jakhon37/autoJetsonBot/tmp_rovodev_long_term_plan.md

# Long-Term Development Plan: ROS2 Control Integration with diffdrive_arduino

## Current State Analysis

### Existing Issues Identified:
1. **Fragmented Control Architecture**: Multiple control paradigms (micro_ros, diffdrive_arduino, legacy GPIO)
2. **Hardcoded Launch Parameters**: No dynamic switching between sim/real
3. **Configuration Inconsistencies**: Different encoder counts, topic names, frame IDs
4. **Missing Hardware Abstraction**: Direct hardware dependencies in launch files
5. **Incomplete Integration**: diffdrive_arduino configured but not properly integrated

## Long-Term Development Plan (6-Month Roadmap)

### Phase 1: Foundation & Cleanup (Month 1-2)
#### 1.1 Unified Configuration System
- Create centralized parameter management
- Standardize encoder resolution across all systems
- Implement environment-specific configuration loading

#### 1.2 Hardware Interface Standardization
- Complete diffdrive_arduino integration
- Remove conflicting micro_ros dependencies
- Standardize communication protocols

#### 1.3 Launch System Refactoring
- Create unified launch architecture
- Implement proper parameter passing
- Add validation and error handling

### Phase 2: Core Integration (Month 2-3)
#### 2.1 ROS2 Control Framework Integration
- Complete diffdrive_arduino hardware interface
- Implement proper controller spawning
- Add real-time performance monitoring

#### 2.2 Simulation-Real Hardware Parity
- Ensure identical behavior between sim and real
- Standardize topic names and frame IDs
- Implement seamless switching mechanism

#### 2.3 Safety & Monitoring Systems
- Add hardware health monitoring
- Implement emergency stop mechanisms
- Create diagnostic and logging systems

### Phase 3: Advanced Features (Month 3-4)
#### 3.1 Hardware Abstraction Layer
- Create modular hardware interfaces
- Implement plugin-based architecture
- Add support for different motor controllers

#### 3.2 Automated Deployment
- Create deployment scripts
- Implement configuration validation
- Add automated testing framework

#### 3.3 Performance Optimization
- Optimize control loop timing
- Implement adaptive control parameters
- Add performance profiling tools

### Phase 4: Production Readiness (Month 4-5)
#### 4.1 Robust Error Handling
- Implement comprehensive error recovery
- Add graceful degradation modes
- Create system health monitoring

#### 4.2 Documentation & Testing
- Complete system documentation
- Implement comprehensive test suite
- Create user guides and tutorials

#### 4.3 Maintenance & Updates
- Create update mechanisms
- Implement version control for configurations
- Add remote monitoring capabilities

### Phase 5: Advanced Features & Optimization (Month 5-6)
#### 5.1 AI/ML Integration
- Implement adaptive control algorithms
- Add predictive maintenance features
- Create learning-based optimization

#### 5.2 Cloud Integration
- Add remote monitoring and control
- Implement data logging and analytics
- Create fleet management capabilities

#### 5.3 Scalability & Modularity
- Design for multiple robot support
- Implement modular sensor integration
- Create extensible architecture

## Implementation Details

### Immediate Actions (Week 1-2)
1. **Audit Current diffdrive_arduino Integration**
2. **Create Unified Parameter Schema**
3. **Design Hardware Abstraction Interface**
4. **Plan Migration Strategy**

### Critical Dependencies
- diffdrive_arduino package compatibility
- ROS2 Control framework version alignment
- Hardware driver stability
- Testing infrastructure setup

### Success Metrics
- Single command deployment (sim/real)
- Zero configuration conflicts
- <100ms control loop latency
- 99.9% system uptime
- Automated testing coverage >90%

### Risk Mitigation
- Maintain backward compatibility during transition
- Implement gradual migration strategy
- Create rollback mechanisms
- Establish comprehensive testing protocols

## Resource Requirements
- Development time: 6 months (1 FTE)
- Hardware testing setup
- Continuous integration infrastructure
- Documentation and training materials

## Expected Outcomes
- Production-ready autonomous robot platform
- Seamless sim-to-real deployment
- Maintainable and extensible codebase
- Comprehensive monitoring and diagnostics
- Industry-standard development practices
