jakhon37/autoJetsonBot/src/robot_body/urdf/robot_dimension.txt

    """ my robot dimensions:

        base: 
            - center point between the wheels: 0 0 0

        chassis:
            - length: 145 mm
            - width: 140 mm
            - height: 70  mm

            - chassis origin point: -30 0 0 mm (behind the center point between the wheels)

    """
