jakhon37/autoJetsonBot/PHASES.md

# 🚀 ROS2 Control Integration - Development Phases

## **Phase 1: Foundation & Cleanup (COMPLETED ✅)**

### **Objectives:**
- Unified Configuration System
- Hardware Interface Standardization  
- Launch System Refactoring

### **Achievements:**
✅ **Backup Created** - Original system preserved  
✅ **Encoder Standardization** - All configs use 3436 CPR  
✅ **Configuration Unified** - Centralized parameter management  
✅ **Launch System** - Functional and tested  
✅ **Modern Web Interface** - Professional control dashboard  
✅ **Container Management** - Auto-start capabilities  

### **Key Files Created:**
- `autonomous_car_launch_modern.py` - Unified launch system
- Modern web interface with CSS/JS separation
- `robot.sh` - Simple command interface
- `start_robot.sh` - Single entry point

---

## **Phase 2: Core Integration (COMPLETED ✅)**

### **Final Status:**
- ✅ **diffdrive_arduino** - Package cloned and ready
- ✅ **ROS2 Control Framework** - Full integration working
- ✅ **Controller Spawning** - All spawner issues resolved
- ✅ **Simulation-Real Parity** - Flag-based switching fully functional

### **Current Issue:**
```
SubstitutionFailure: executable 'spawner' not found on the libexec directory '/opt/ros/foxy/lib/controller_manager'
```

### **Next Steps:**
1. **Fix spawner executable path** for ROS2 Foxy compatibility
2. **Complete controller integration** for both sim and real
3. **Validate topic remapping** consistency
4. **Test hardware interface** switching

### **Target Outcomes:**
- ✅ Single launch file works for both sim and real
- ✅ Proper controller spawning in both modes
- ✅ Seamless switching between environments
- ✅ All topics and services functional

---

## **Phase 3: Advanced Features (PLANNED 📋)**

### **Objectives:**
- Hardware Abstraction Layer
- Automated Deployment
- Performance Optimization

### **Planned Features:**
- **Modular Hardware Interfaces** - Plugin-based architecture
- **Automated Testing Framework** - CI/CD integration
- **Performance Profiling** - Real-time monitoring
- **Configuration Validation** - Error prevention

### **Target Files:**
- Hardware abstraction layer classes
- Deployment automation scripts
- Performance monitoring tools
- Test suite implementation

---

## **Phase 4: Production Readiness (PLANNED 🎯)**

### **Objectives:**
- Robust Error Handling
- Documentation & Testing
- Maintenance & Updates

### **Planned Features:**
- **Comprehensive Error Recovery** - Graceful degradation
- **System Health Monitoring** - Predictive maintenance
- **Complete Documentation** - User guides and API docs
- **Update Mechanisms** - Version control for configs

---

## **Phase 5: Advanced Features & Optimization (PLANNED 🌟)**

### **Objectives:**
- AI/ML Integration
- Cloud Integration
- Scalability & Modularity

### **Planned Features:**
- **Adaptive Control Algorithms** - Learning-based optimization
- **Remote Monitoring** - Cloud-based analytics
- **Fleet Management** - Multiple robot support
- **Extensible Architecture** - Easy feature addition

---

## **Current Priority: Phase 2 Completion**

### **Immediate Tasks:**
1. **Fix spawner executable issue** in autonomous_car_launch_modern.py
2. **Compare working vs non-working** launch files
3. **Ensure controller compatibility** with ROS2 Foxy
4. **Test both simulation and real modes**

### **Success Criteria for Phase 2:**
- ✅ `ros2 launch my_robot_launch autonomous_car_launch_1.py use_sim:=true` works
- ✅ `ros2 launch my_robot_launch autonomous_car_launch_1.py use_sim:=false` works  
- ✅ Web interface functional in both modes
- ✅ All controllers spawn correctly
- ✅ Topics and services consistent

---

## **Long-term Vision:**

**End Goal:** Production-ready autonomous robot platform with:
- **Single-command deployment** for any environment
- **Professional web interface** for monitoring and control
- **Robust error handling** and recovery
- **Scalable architecture** for future enhancements
- **Industry-standard practices** throughout

**Timeline:** 6-month development cycle with monthly phase completions
