jakhon37/autoJetsonBot/assets/circuit_image.png

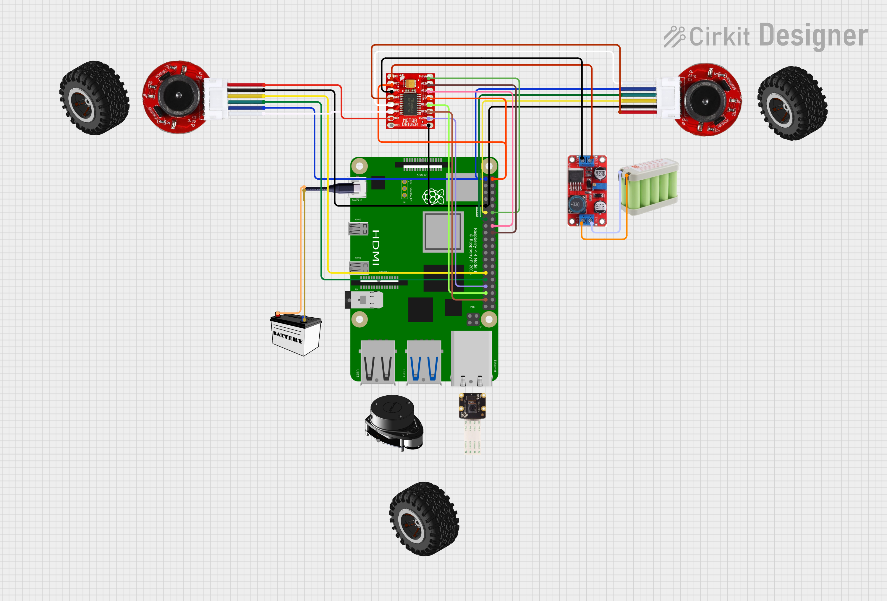
assets/circuit_image.png
