jakhon37/autoJetsonBot/assets/encoder.jpg

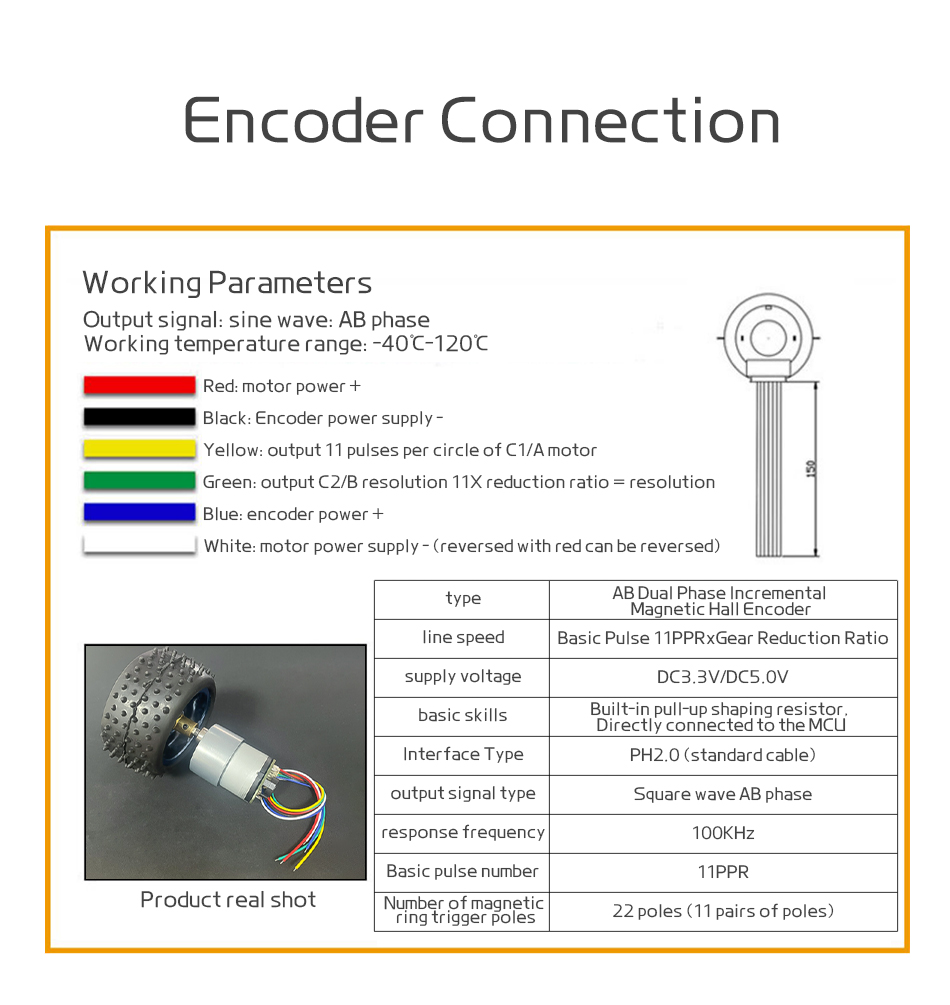
assets/encoder.jpg
