jakhon37/autoJetsonBot/assets/gitpage.png

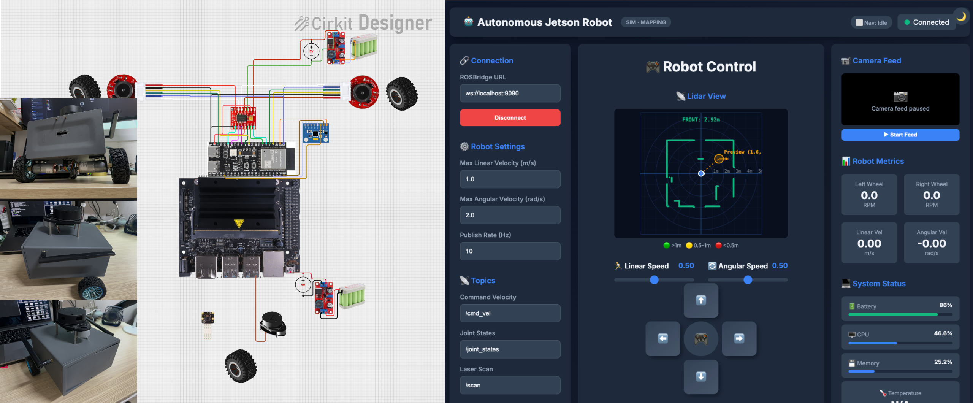
assets/gitpage.png
