jakhon37/autoJetsonBot/assets/jetson/16536_11.jpg

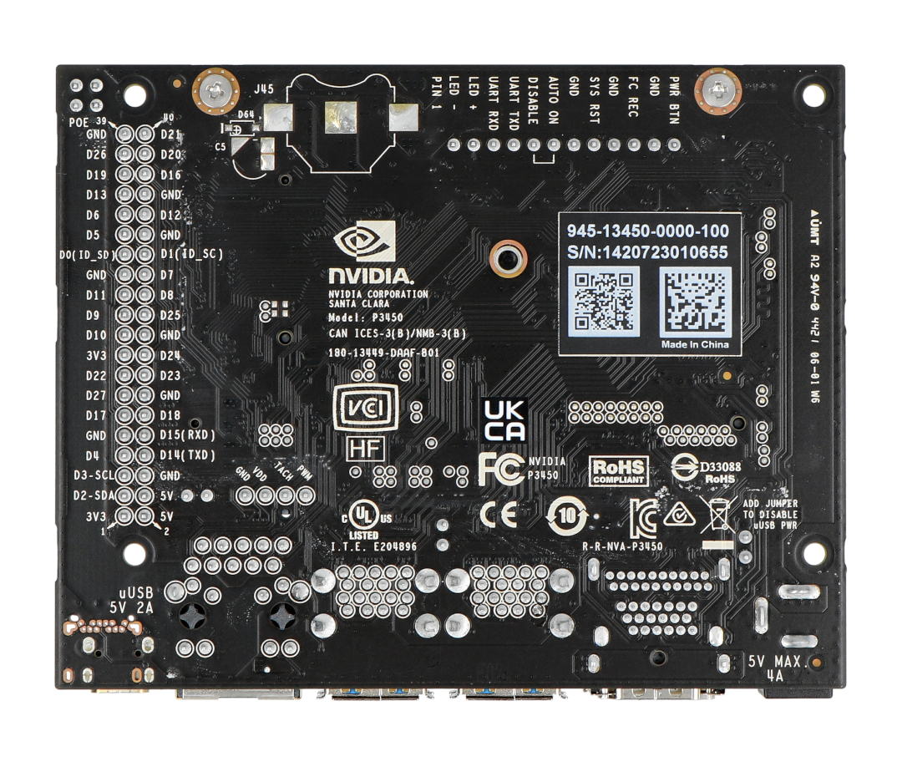
assets/jetson/16536_11.jpg
