jakhon37/autoJetsonBot/assets/jetson/image_2823.jpg

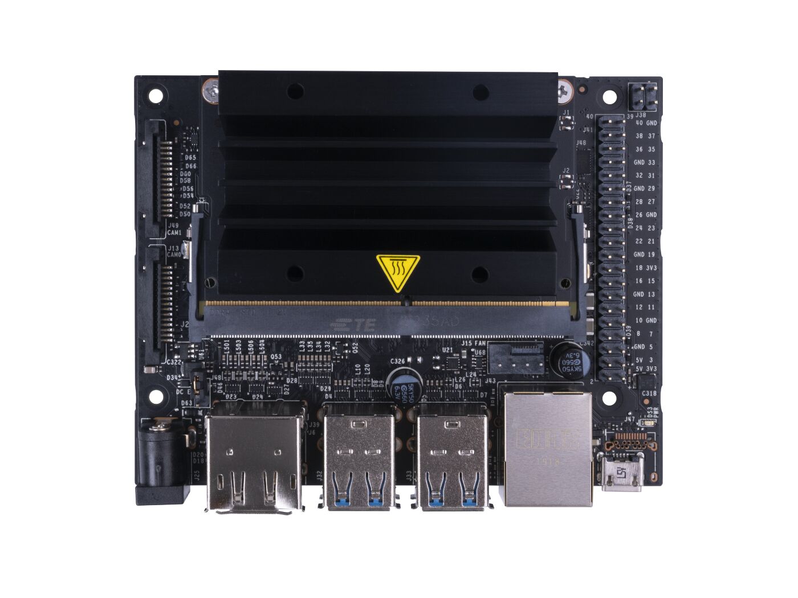
assets/jetson/image_2823.jpg
