jakhon37/autoJetsonBot/assets/jetson/nano_b1 board.png

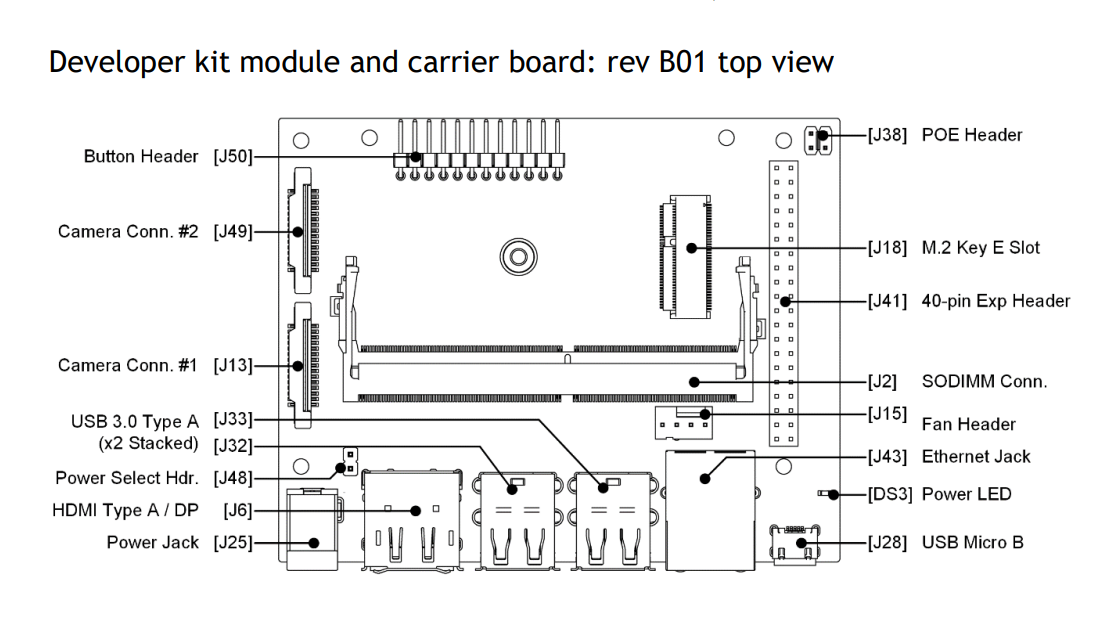
assets/jetson/nano_b1 board.png
