jakhon37/autoJetsonBot/assets/motor.png

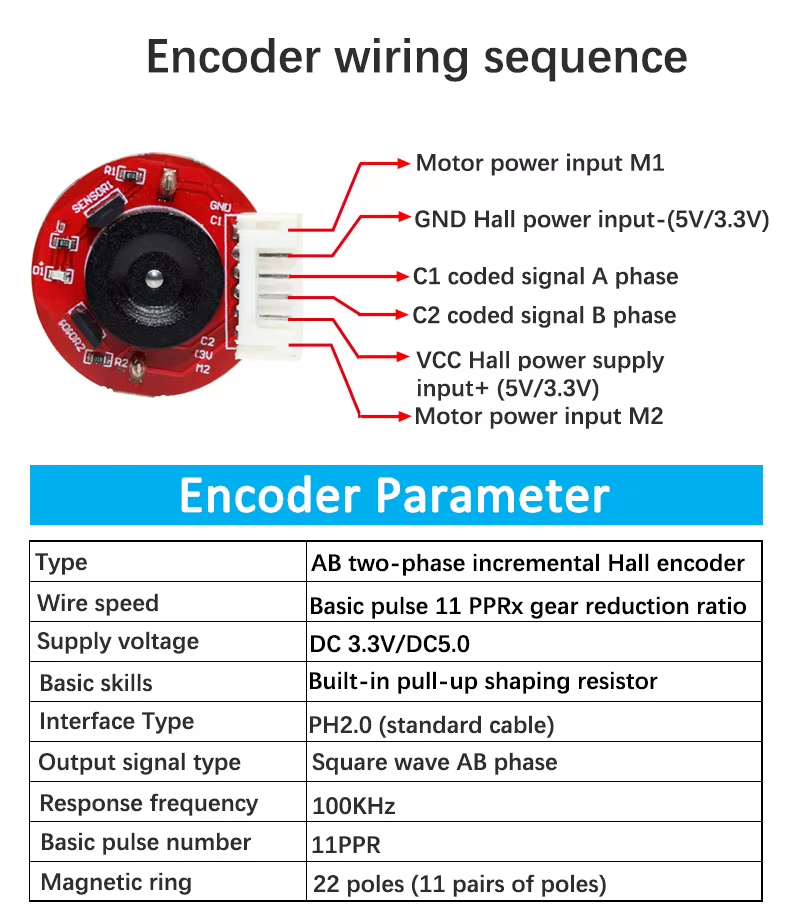
assets/motor.png
