jakhon37/autoJetsonBot/assets/photo_2025-02-12_20-30-53.jpg

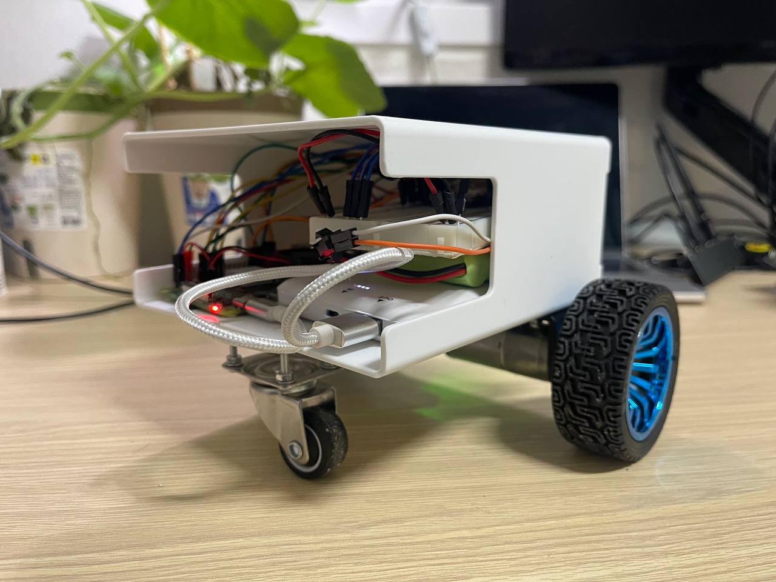
assets/photo_2025-02-12_20-30-53.jpg
