jakhon37/autoJetsonBot/assets/reference/jetson-nano/5153.contentimage_114266.png-870x687.png

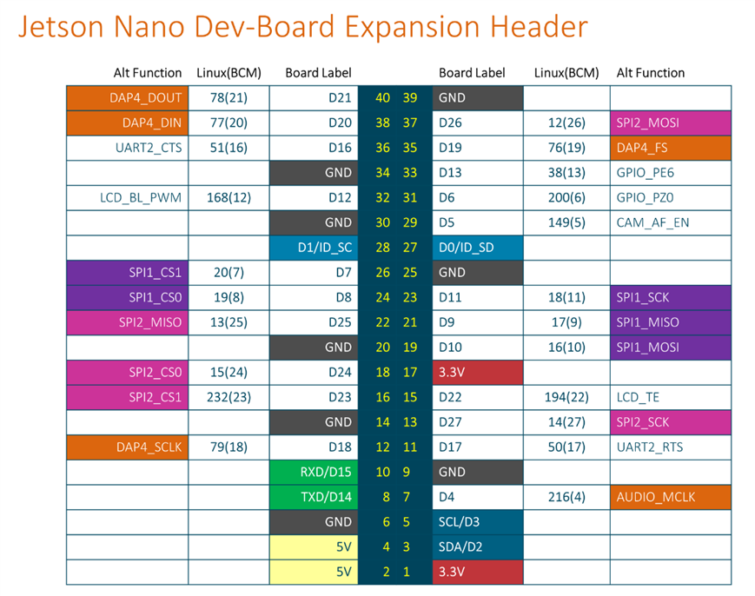
assets/reference/jetson-nano/5153.contentimage_114266.png-870x687.png
