jakhon37/autoJetsonBot/assets/rplidar.jpg

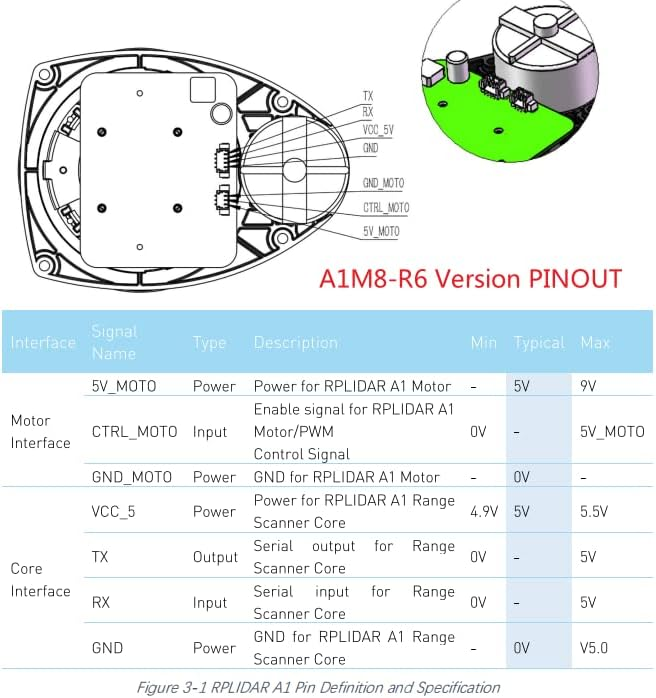
assets/rplidar.jpg
