jakhon37/autoJetsonBot/assets/sim/rviz_costmap_2026-06-05.png

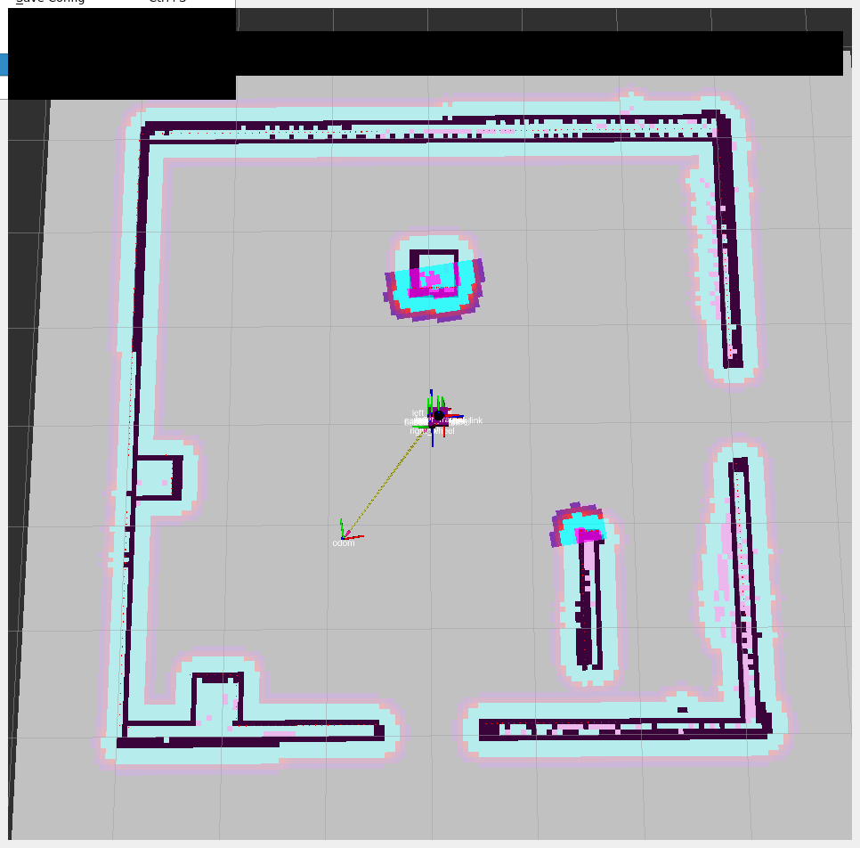
assets/sim/rviz_costmap_2026-06-05.png
