jakhon37/autoJetsonBot/assets/thub.png

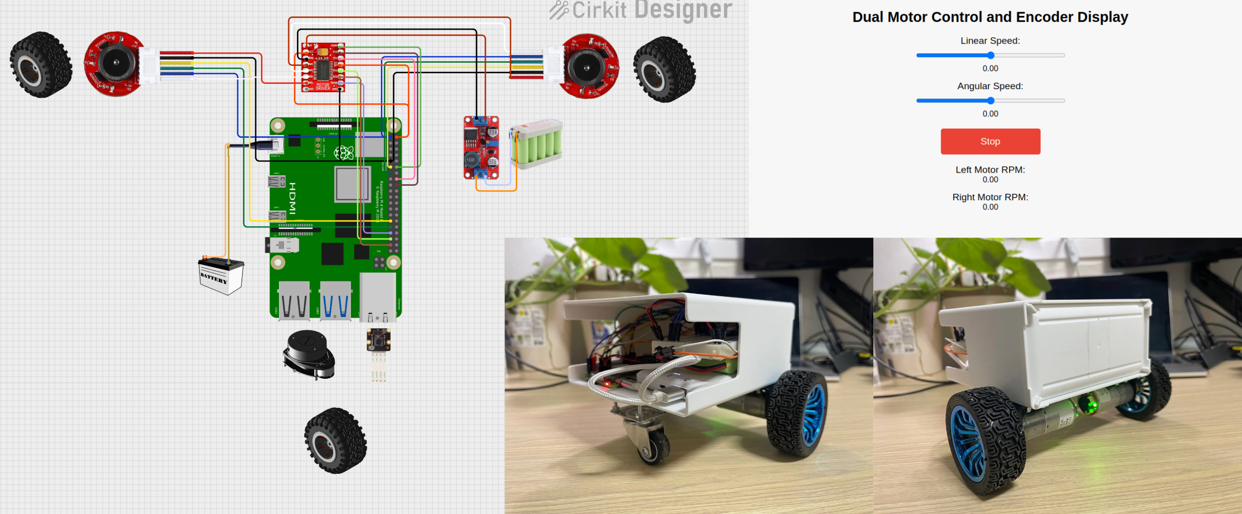
assets/thub.png
