jakhon37/autoJetsonBot/assets/thubnl.png

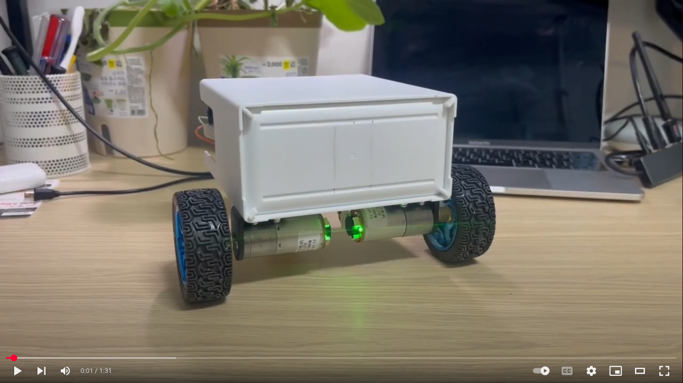
assets/thubnl.png
