jakhon37/autoJetsonBot/assets/web_r.png

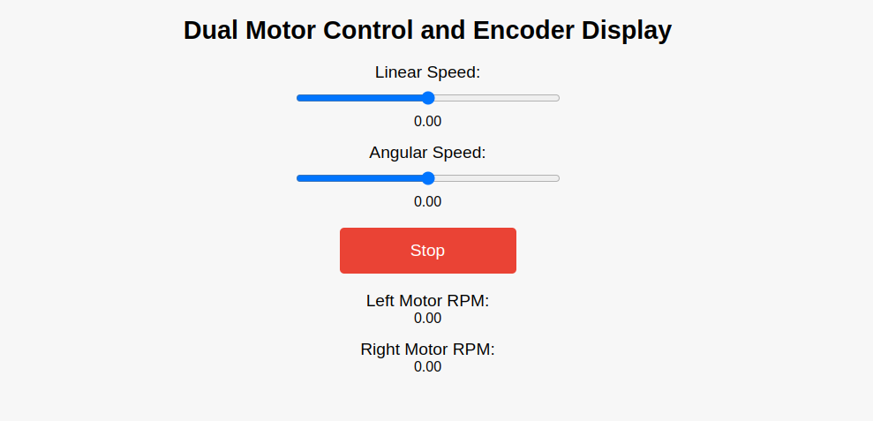
assets/web_r.png
