jakhon37/autoJetsonBot/assets/web_ui.png

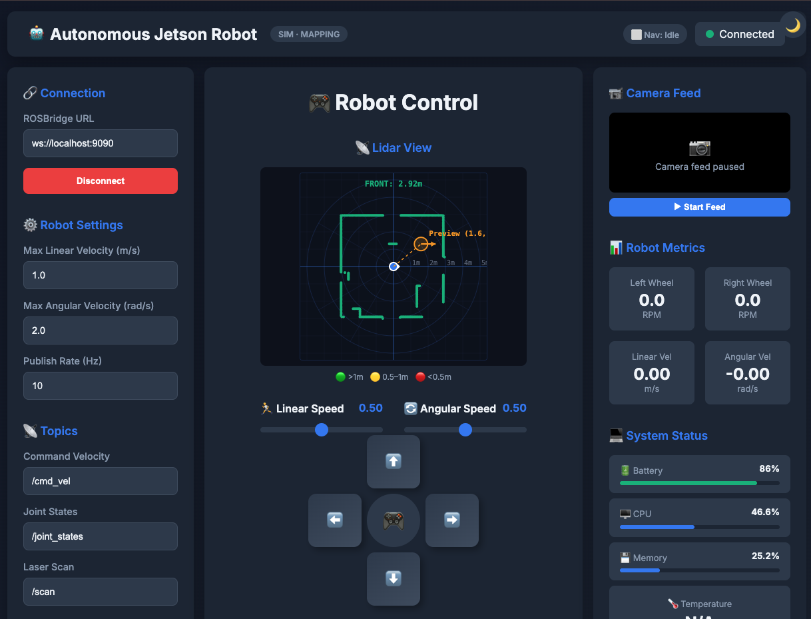
assets/web_ui.png
