jakhon37/autoJetsonBot/SLAM_CONFIGURATION_GUIDE.md

# 🗺️ SLAM Configuration System Guide

## ✨ New Features Added

### **🔄 Dynamic SLAM Mode Switching**
The robot now supports easy switching between **mapping** and **localization** modes without code changes!

### **📁 Organized Map Management**
- Dedicated `maps/` directory for storing map files
- Automatic map saving and loading
- Map versioning and naming

### **🎮 Simple Control Interface**
New `robot_slam.sh` script for easy SLAM operations

---

## 🚀 Quick Start

### **Create New Maps (Mapping Mode)**
```bash
# Start simulation in mapping mode
./robot_slam.sh mapping sim

# Start real robot in mapping mode  
./robot_slam.sh mapping robot

# Save map when done exploring
./robot_slam.sh save-map office_floor1
```

### **Use Existing Maps (Localization Mode)**
```bash
# Start simulation with existing maps
./robot_slam.sh localization sim

# Start real robot with existing maps
./robot_slam.sh localization robot
```

### **Manage Maps**
```bash
# List all available maps
./robot_slam.sh list-maps

# Check robot and SLAM status
./robot_slam.sh status
```

---

## 📋 Available Commands

| Command | Description | Example |
|---|---|---|
| `mapping [sim\|robot]` | Create new maps | `./robot_slam.sh mapping sim` |
| `localization [sim\|robot]` | Use existing maps | `./robot_slam.sh localization robot` |
| `save-map [name]` | Save current map | `./robot_slam.sh save-map kitchen` |
| `list-maps` | Show available maps | `./robot_slam.sh list-maps` |
| `status` | Show system status | `./robot_slam.sh status` |

---

## 🎯 Usage Examples

### **Scenario 1: First Time Setup**
```bash
# 1. Start robot in mapping mode
./robot_slam.sh mapping sim

# 2. Drive robot around to create map
# Use web interface: http://localhost:8000

# 3. Save the map when done
./robot_slam.sh save-map my_house

# 4. Switch to localization mode
./robot_slam.sh localization sim
```

### **Scenario 2: Production Use**
```bash
# Use existing maps for navigation
./robot_slam.sh localization robot

# Robot will localize itself on the existing map
# Ready for autonomous navigation!
```

### **Scenario 3: Map Management**
```bash
# Check what maps are available
./robot_slam.sh list-maps

# Create a new map for different area
./robot_slam.sh mapping robot
./robot_slam.sh save-map warehouse_section_a

# Switch between different maps by updating config
```

---

## ⚙️ Technical Details

### **Configuration Files**
- `slam_config_mapping.yaml` - For creating new maps
- `slam_config_localization.yaml` - For using existing maps

### **Map Storage**
- **Host Location**: `./maps/` directory
- **Container Location**: `/ros2/maps/` (auto-mounted)
- **File Format**: `.data` and `.posegraph` files

### **Launch Parameters**
```bash
# New slam_mode parameter added
ros2 launch my_robot_launch autonomous_car_launch_1.py \
    use_sim:=true \
    slam_mode:=mapping

ros2 launch my_robot_launch autonomous_car_launch_1.py \
    use_sim:=false \
    slam_mode:=localization
```

---

## 🔧 Advanced Configuration

### **Custom Map Locations**
Edit `slam_config_localization.yaml` to change map file paths:
```yaml
map_file_name: /ros2/maps/custom_map_name
```

### **SLAM Parameters**
Both config files support full SLAM toolbox parameter customization:
- Resolution, laser range, loop closure settings
- Scan matching parameters
- Performance tuning options

### **Docker Volume Mounting**
Maps are automatically accessible via docker-compose volume:
```yaml
volumes:
  - ./maps:/ros2/maps
```

---

## 🎉 Benefits

### **✅ User Experience**
- **One Command**: Simple switching between modes
- **No Code Changes**: Configuration-driven approach
- **Error Prevention**: Automatic validation and helpful messages

### **✅ Development**
- **Faster Testing**: Quick mode switching for development
- **Map Reuse**: Save and reuse maps across sessions
- **Organized Storage**: Clean map file management

### **✅ Production**
- **Reliable Localization**: Use proven maps for navigation
- **Performance**: Optimized configs for each mode
- **Scalability**: Easy to add new maps and environments

---

## 🚀 Next Steps

This SLAM configuration system enables:
1. **Autonomous Navigation**: Use localization mode for path planning
2. **Multi-Environment Support**: Different maps for different areas
3. **Fleet Management**: Shared maps across multiple robots
4. **AI Integration**: Maps as input for intelligent navigation

**Phase 2 Enhancement Complete!** 🎯
