jakhon37/autoJetsonBot/docs/experiments/RESULTS.md

# Experiments and Results

What was tested, on what, and what it showed. Simulation work ran in Docker on a Mac in June 2026, and on an amd64 PC under Humble in November. Hardware work ran on the robot's Jetson Xavier NX under ROS 2 Humble from August to November 2026. Day-by-day detail is in [SESSION_LOG.md](../SESSION_LOG.md), and open problems are on the status board in [PROJECT_ANALYSIS.md](../PROJECT_ANALYSIS.md).

## At a Glance

| # | Experiment | Where | When | Outcome |
| :- | :--- | :--- | :--- | :--- |
| 1 | [SLAM and Nav2 in Gazebo](#1-simulation-mapping-and-navigation-in-gazebo) | Simulation | 2026-06 | Map built and goals reached with fused odometry |
| 2 | [Port to ROS 2 Humble](#2-port-to-ros-2-humble-on-the-xavier-nx) | Xavier NX | 2026-08 to 11 | Stack builds and runs in Docker on the robot |
| 3 | [Lidar and SLAM on the robot](#3-lidar-and-slam-on-the-real-robot) | Robot | 2026-08-21, 11-05 | 6.46 Hz scans, `slam_toolbox` builds a map |
| 4 | [ESP32-S3 telemetry](#4-esp32-s3-telemetry-and-the-tf-chain) | Robot | 2026-11-05 | Encoders and IMU at 50 Hz, full TF chain |
| 5 | [Wheel encoder hand test](#5-wheel-encoder-hand-test) | Robot | 2026-11-06 | Found a 9 to 10× scale error and missing direction before the first drive |
| 6 | [IMU at rest](#6-imu-at-rest) | Robot | 2026-11-05 | Gyro bias of 1.4°/s measured, calibration pending |
| 7 | [ESP32-CAM video over Wi-Fi](#7-esp32-cam-video-over-wi-fi) | Camera | 2026-11-05 to 06 | 10 fps at 320×240, firmware fixes tested on hardware |
| 8 | [Gazebo check of the code review fixes](#8-gazebo-check-of-the-code-review-fixes) | Simulation | 2026-11-09 | Fixes confirmed, and three more bugs found and fixed |
| 9 | [First drive with the new motor firmware](#9-first-drive-with-the-new-motor-firmware) | Robot | 2026-11-09 to 10 | Encoders fixed, 1,497 counts per turn, speeds within 1 to 2% with the wheels lifted |
| 10 | [Driving through ROS and the EKF heading](#10-driving-through-ros-and-the-ekf-heading) | Robot | 2026-11-10 | `/odom` within 3% of commands, and the EKF now follows turns |
| 11 | [Floor tuning, gyro offsets and the EKF](#11-floor-tuning-gyro-offsets-and-the-ekf-on-the-floor) | Robot, simulation | 2026-11-10 | Feed-forward set for the floor, gyro offsets in firmware, and EKF settings that turned straight drives into turns, fixed |
| 12 | [The EKF on the robot and the lidar's frame](#12-the-ekf-on-the-robot-the-lidars-frame-and-the-left-encoder) | Robot, simulation | 2026-11-10 | The EKF matched the wheels and the gyro, and the lidar's frame, 90° off, corrected |

---

## 1. Simulation: Mapping and Navigation in Gazebo

**Goal:** Prove the full stack (URDF, `slam_toolbox`, AMCL, Nav2, Web UI) on a digital twin before touching the hardware.

**Setup:** Gazebo Classic with the `lab_small_light` world, ROS 2 Foxy in Docker on macOS, RViz over VNC. The robot model uses the chassis measurements from the 2026-06-07 hardware audit (wheel radius 0.034 m, separation 0.212 m, chassis 19.4 × 17.8 × 9.7 cm, lidar 0.064 m ahead of the axle and 0.217 m above the floor).

<p align="center">
  Gazebo lab world with the robot's lidar rays as it moves
  <br>
  <em>The robot driving in the Gazebo lab world, lidar rays in blue</em>
</p>

| Mapping (Gazebo + RViz scan) | Navigation (Nav2 costmap) |
| :---: | :---: |
| Gazebo lab world and the RViz laser scan | Nav2 global costmap with inflated walls, beside Gazebo |

<p align="center">
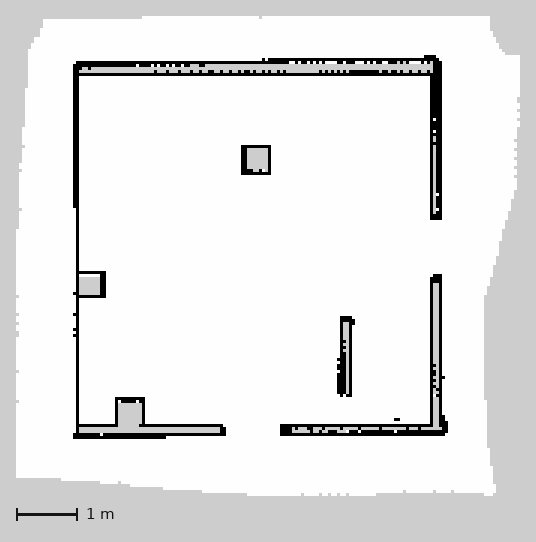
[picture p21: assets/results/map_sim_lab_world.png]
Occupancy grid of the simulated lab world
  
  <br>
  <em>Occupancy grid of the simulated lab, used by AMCL and Nav2 (<code>src/jetson_bot_bringup/worlds/lab_map_v2.pgm</code>)</em>
</p>

**Result:** Mapping and autonomous goals worked in simulation with EKF-fused odometry (`/odom_filtered`). The simulation ran at a real-time factor of about 0.55 in Docker on the Mac. A later code review found that in simulation both the diff-drive controller and the EKF published the `odom → base_footprint` transform. That's fixed, and [experiment 8](#8-gazebo-check-of-the-code-review-fixes) checked it.

**Lessons, recorded in [LESSONS_LEARNED.md](../LESSONS_LEARNED.md):**
- The robot looked stuck until the URDF put `base_footprint` at the floor and the model spawned 6 cm up. The wheels had been under the ground plane.
- Lowering contact stiffness to speed up physics let overlapping geometry push the robot around, so the geometry had to be fixed first.
- Inflation `cost_scaling_factor` sets how fast cost falls away from walls. Low values make walls look thick, and both Nav2 configs settled on 3.5.

---

## 2. Port to ROS 2 Humble on the Xavier NX

**Goal:** Move from the original Jetson Nano with native Foxy to a Jetson Xavier NX running ROS 2 Humble.

**What changed:**
- **Container:** `Dockerfile.humble` builds `auto_ros:humble` (Ubuntu 22.04). The host stays on L4T R35.6 (Ubuntu 20.04), so Docker is what makes Humble possible on this board.
- **Launch:** `main.launch.py` adapts per distro: `spawner.py` becomes `spawner`, `slam_toolbox` takes `slam_params_file`, and Nav2 loads `nav2_params_humble.yaml`.
- **Serial ports:** The ESP32-S3 and the lidar are found by USB ID, because `ttyACM` numbers change when the ESP32 resets.

**Limits found:**
- **Gazebo:** Gazebo Classic has no Humble packages for arm64, so simulation needs an amd64 host. The robot itself runs hardware mode only.
- **Camera:** It turned out to be an ESP32-CAM on Wi-Fi, not the CSI Pi Camera in the old docs, so the kernel's `imx219` errors were expected.

---

## 3. Lidar and SLAM on the Real Robot

**Setup:** RPLidar A1 on the Xavier NX's USB (CP2102 adapter), `rplidar_ros` and `slam_toolbox` in the Humble container.

| Measure | Value |
| :--- | :--- |
| Lidar health | OK (firmware 1.29, hardware rev 7) |
| `/scan` rate | 6.46 Hz, 360 points per scan |
| Valid points | 40%, most of the rest within 30 cm, so something on the chassis is in the beam |

<p align="center">
  Noisy occupancy grid from the real lidar
  <br>
  <em>Map saved by the robot on 2026-08-21 (<code>maps/lab_map_v2.pgm</code>)</em>
</p>

**Result:** `slam_toolbox` builds maps from the real lidar. The August map is smeared, which fits the encoder problems found in experiment 5, since odometry was reporting about a tenth of the real distance at the time. A full mapping run with calibrated odometry is still to come.

---

## 4. ESP32-S3 Telemetry and the TF Chain

**Setup:** ESP32-S3 on its native USB socket (`303a:1001`), the Python bridge `diffdrive_node`, `imu_bridge_node`, the Madgwick filter and the EKF. No motor commands were sent.

| Topic | Rate | Source |
| :--- | :--- | :--- |
| Encoder `e` lines | 50 Hz | ESP32-S3 serial |
| IMU `i` lines | 50 Hz | ESP32-S3 serial |
| `/odom` | 50 Hz | `diffdrive_node` |
| `/joint_states` | 50 Hz | `diffdrive_node` |
| `/imu/data` | 50 Hz | Madgwick filter |
| `/odom_filtered` | 30 Hz | `robot_localization` EKF |

**Result:** The full TF chain `map → odom → base_footprint → base_link → sensors` was present, and `slam_toolbox` built a map with it.

**Fix found here:** On startup the bridge treated the ESP32's accumulated counts as motion, which put `/odom` at (-3.13, -2.72). It now takes its first reading as a baseline, and `/odom` starts at zero (2026-11-05 23:15 in the session log).

---

## 5. Wheel Encoder Hand Test

**Goal:** Check encoder scale and direction before the first powered drive.

**Method:** With the robot still, each wheel was turned by hand 5 times forward and 5 times back, left first, while the counts were logged once a second.

<p align="center">
  <picture>
    <source media="(prefers-color-scheme: dark)" srcset="../../assets/results/encoder_counts_dark.svg">
    Bar chart: left wheel 344 and right wheel 387 counts per turn, against 3,436 configured
  </picture>
</p>

| Wheel | Count change over 10 turns | Counts per turn | Configured |
| :--- | ---: | ---: | ---: |
| Left | -3,437 | 344 | 3,436 |
| Right | +3,866 | 387 | 3,436 |

**Findings:**
- **Scale:** The encoders report 9 to 10 times fewer counts per turn than the bridge is configured for, so odometry would show about a tenth of the real distance. The left wheel's 10-turn total is almost exactly 3,436, so that value may have been measured over 10 turns and recorded as one.
- **Direction:** Neither count reversed. The left count only fell and the right only rose, which is what the firmware does when the encoder's B channel reads high, as an unconnected input with a pull-up would. Every motion would then read as backward. This holds if the second five turns really were backward.

**Next:** Done in [experiment 9](#9-first-drive-with-the-new-motor-firmware). Both B channels were dead, and the rebuilt firmware, counting all four edges, measures 1,497 per turn, inside the 1,376 to 1,546 that four times this test's counts predicted.

---

## 6. IMU at Rest

**Setup:** MPU6050 on the ESP32-S3's I2C bus (SDA GPIO 1, SCL GPIO 21), read at 50 Hz and sent over the same serial link as the encoders.

| Measure | Value |
| :--- | :--- |
| Acceleration magnitude | 9.77 m/s² |
| Gyro z at rest | about 0.024 rad/s (1.4°/s) |
| `/odom_filtered` yaw drift | about 0.1°/s |

**Result:** The IMU works, but its gyro bias needs calibrating before it helps the EKF. Gyro values also arrive with only 2 decimals, in steps of 0.01 rad/s, which limits how finely the bias can be estimated.

**Found in code review:** The Madgwick filter runs in `stateless` mode without a magnetometer, so its orientation has no real heading, yet the EKF fused its yaw. [Experiment 10](#10-driving-through-ros-and-the-ekf-heading) showed it pinned the heading, and the EKF now fuses only the IMU's yaw rate. The bridge also published `/odom` with zero covariance, which the EKF treats as near-perfect. Since 2026-11-07 it sends non-zero variances.

---

## 7. ESP32-CAM Video over Wi-Fi

**Setup:** AI-Thinker ESP32-CAM (OV2640) streaming MJPEG over Wi-Fi from its own firmware, [myESP32CAM-BLACKBOX](https://github.com/jakhon37/myESP32CAM-BLACKBOX). It isn't connected to ROS in this repo yet.

**Firmware changes:** Branch `wifi-reliability` of that repo, flashed and tested on the camera:

| Change | How it was checked | Result |
| :--- | :--- | :--- |
| Turn off Wi-Fi power saving | Idle ping, 15 minutes apart | 290 to 330 ms down to about 13 ms (median) |
| Retry home Wi-Fi every 30 s while on the fallback hotspot | Wrong network name, then a 1 ms boot timeout | Hotspot stays up while retries fail. A successful retry joins in about 1 s and turns the hotspot off |
| Restart if the sensor fails to start | Not tested on hardware yet | Previously it halted with no network |

<p align="center">
  <picture>
    <source media="(prefers-color-scheme: dark)" srcset="../../assets/results/camera_fps_dark.svg">
    Column chart: 10.1 fps at 160x120, 9.3 at 320x240, 4.1 at 640x480, 3.2 at 800x600
  </picture>
</p>

| Resolution | Frame size | From the wired PC | From the Jetson |
| :--- | ---: | ---: | ---: |
| 160×120 | 2.9 KB | 10.1 fps | Not measured |
| 320×240 | 8.2 KB | 9.3 fps | 9.8 fps |
| 640×480 | 23.6 KB | 4.1 fps | 2.9 fps |
| 800×600 | 34 KB | 3.2 fps | Not measured |

**Findings:**
- **Throughput:** 320×240 runs close to the firmware's 10 fps limit. At 640×480, frame rate falls as frames get bigger, and a 20-minute run averaged about 6 fps.
- **Stalls:** Pauses of up to 3 s at 640×480 aren't explained by bandwidth, and their cause is unknown.
- **Open problems:** One boot gave no frames at all at 640×480 or larger for 20 minutes, while smaller sizes worked. Its cause is unknown. A slowdown the night before, when an 18 KB page downloaded at about 5 KB/s, cleared after the camera moved to a phone charger, but power, position and time of day changed together.
- **Design limits for the ROS node:** The firmware serves one request at a time and its frames carry no timestamps. `/capture` also saves every photo to the SD card, so a ROS node should be the stream's only client, stamp frames on arrival, and avoid polling `/capture`.

---

## 8. Gazebo Check of the Code Review Fixes

**Goal:** Run the 2026-11-07 code review fixes in simulation before they reach the robot.

**Setup:** ROS 2 Humble in Docker on an amd64 PC (Ubuntu 24.04, 12 cores, no GPU), because Gazebo Classic has no Humble packages for arm64. Headless Gazebo ran at a real-time factor of 1.0. The container ran with `ROS_LOCALHOST_ONLY=1`, so nothing it published could reach the robot on the same network.

| Check | Result |
| :--- | :--- |
| `diff_cont`'s transform turned off | `enable_odom_tf` reads false |
| Only the EKF publishes `odom → base_footprint` | 90 of 90 samples equal an `/odom_filtered` pose with the same stamp |
| Transform while driving | Largest step 1.5 cm, none out of order |
| Simulated `/odom` covariance | The same non-zero values as the robot's bridge |
| `run_tests.py --docker` with the stack up | 10 of 10 passed |
| Dashboard goals | Reached Nav2 and succeeded |
| Dashboard cancel | Robot stopped within 0.6 s of the click |

**Found: the simulated EKF turned the wrong way.** The URDF mounts the IMU upside down (roll π), and its Gazebo plugin named no frame. Gazebo merges links on fixed joints, so the readings were stamped `base_footprint`, and the EKF fused them without rotating them back. The diff-drive controller's own transform had hidden this until the fix above turned it off.

| Heading change in a 4 s counter-clockwise spin | Before | After |
| :--- | ---: | ---: |
| `/odom` from the wheels | +100° | +100° |
| `/imu` orientation | +95° | +95° |
| EKF (`/odom_filtered` and its transform) | −86° to −95° | +95° |

<p align="center">
  Occupancy grid that slam_toolbox built while the robot drove in the Gazebo lab world
  <br>
  <em>SLAM map built in Gazebo under Humble after the fixes (2026-11-09)</em>
</p>

With the heading reversed, SLAM drew the room rotated with doubled walls. Nav2 weaved on a straight 1.7 m goal, turning at up to 0.84 rad/s and drifting 18 cm sideways in its first metre. Naming the frame `imu_link` in `imu.xacro` fixed both: SLAM now draws the room's walls straight (above), and the same goal drifted 7 cm over 1.5 m. A unit test now checks the frame.

**Found: the dashboard badge stuck at Canceling.** Nav2 sends CANCELED 20 ms after CANCELING and publishes status only on a change. The dashboard throttled that topic to one message per 500 ms, and rosbridge drops messages inside the window rather than delaying them, so CANCELED never arrived. Without the throttle, the badge goes from Executing through Canceling to Idle within 30 ms of the cancel.

**Found: the simulated camera's frame.** `camera.xacro` used ROS 1's `<frameName>` tag, which the ROS 2 plugin ignores, so the images were stamped `base_footprint`. With `<frame_name>` they're stamped `camera_optical_link`, and the unit test covers the camera too.

**Result:** Every fix that simulation can exercise works, and all three new bugs are fixed. The bridge's odometry changes can only be checked on the robot. Still open from this run: Gazebo's 10 Hz clock holds the EKF to 10 Hz, and simulated navigation loads the robot's map by default.

---

## 9. First Drive with the New Motor Firmware

**Goal:** Put the rebuilt motor firmware on the ESP32-S3, fix whatever stopped the encoders, and drive both wheels for the first time under Humble.

**Setup:** The robot on a stand with the wheels lifted about 5 mm. The firmware is the `quadrature-speed-control` branch of [MOTOR-ESP32S3](https://github.com/jakhon37/MOTOR-ESP32S3): quadrature decoding on all 4 edges in hardware, feed-forward plus a closed loop per wheel, and a 500 ms command timeout. Its `wheel_test.py` ran in the Jetson's container, following that repo's first-drive checklist. The old firmware, never committed, was backed up first.

**Found and fixed:**
- **Board in download mode:** After the Jetson rebooted, every reset through the USB control lines started the ESP32-S3 in ROM download mode (`boot:0x2`), silent with the motors off. Unplugging its USB cable for 5 s fixed it.
- **No motor power:** The first commands raised the PWM but moved nothing, until the motor battery was connected to the driver.
- **Dead B channels:** In a 3 s drive, channel A changed 282 times on the left and 281 on the right, and B never changed. The left green wire was broken, and the firmware expected the left B on GPIO 17, while the wiring diagram and the robot have it on 14. With all 4 edges counted, a stuck B cancels every A pulse, so the counts stayed at 0. The old firmware counted A alone, which is why experiment 5 never saw a count reverse.
- **Left count backwards:** The left motor is mounted mirrored, so its encoder's sign was flipped.

| Measure | Left | Right |
| :--- | ---: | ---: |
| Counts per wheel turn, 10 turns forward / back | 1,497 / 1,496 | 1,500 / 1,496 |
| Starts from rest at | PWM 125 | PWM 125 |
| Deadband, slope | 51 PWM, 1,743 PWM per m/s | 42 PWM, 1,732 PWM per m/s |
| Closed-loop speed against request, 0.02 to 0.25 m/s both ways | within 1 to 2% | within 1 to 2%, 8% at −0.02 m/s |

**Result:** 1,497 counts per turn is 4 edges × 11 pulses × a 34:1 gearbox. The bridge had 3,436, which would have put `/odom` at 43% of the real distance, and now has 1,497. A gentle arc requested at 0.05 and 0.20 m/s ran at 0.051 and 0.202 m/s, a 0.005 m/s request moved neither wheel, and the wheels stopped 0.75 s after the last command. The measured values are in the firmware and flashed. All of this was with the wheels in the air, so driving through ROS and on the floor come next.

---

## 10. Driving Through ROS and the EKF Heading

**Goal:** Drive the lifted wheels through `/cmd_vel` with the full hardware stack, and check that the EKF's heading follows a turn the wheels don't see.

**Setup:** `./robot.sh robot` on the Jetson, with the robot on its stand and nothing else publishing `/cmd_vel`. A script sent 0.1 m/s forward for 3 s, then 0.5 rad/s left for 3 s, and read `/odom`. Then, with the wheels still, the robot was turned about 90° left by hand, flat on the table, and the change was measured between two key presses.

| Check | Expected | Measured |
| :--- | ---: | ---: |
| `/cmd_vel` forward, distance on `/odom` | 0.30 m | 0.308 m, heading −0.3° |
| `/cmd_vel` left turn, heading on `/odom` | +86° | +89.9°, 0.001 m |
| Hand turn, IMU gyro in its own upside-down frame | negative, about −90° | −107°, with the gyro bias |
| Hand turn, EKF heading, fusing Madgwick's yaw | about +90° | +5.6° |
| Hand turn, EKF heading, fusing only the IMU's yaw rate | about +90° | +105°, with the gyro bias |

**Result:** Through ROS, the bridge, firmware and encoders match the commands within 3%, with every sign right. The IMU is upside down as the URDF says. The EKF, though, was fusing the Madgwick filter's yaw, which holds no heading without a magnetometer, so a flat turn hardly moved it. It now fuses only the IMU's yaw rate and follows the turn. What's left is the uncalibrated gyro bias of about 1.4°/s, which now drifts `/odom_filtered`'s heading about 1°/s at rest.

---

## 11. Floor Tuning, Gyro Offsets and the EKF on the Floor

**Goal:** Set the motor feed-forward for the floor, remove the gyro's offsets at rest, and drive through ROS on the floor.

**Setup:** The robot on the floor of the room it maps. First `MOTOR-ESP32S3`'s `wheel_test.py hold --on-floor` at 0.03 and 0.15 m/s, following step 10 of its first-drive checklist. Then the gyro read at rest for 60 s, with nothing sent to the board. Then `./robot.sh robot` and a script that sent 0.1 m/s for 3 s and 0.5 rad/s for 3 s through `/cmd_vel`, and compared `/odom`, `/odom_filtered`, the gyro and SLAM's map pose.

| Check | Before | After |
| :--- | ---: | ---: |
| Floor trims at 0.03 / 0.15 m/s, left wheel (PWM) | +11 / +29 | +9 / 0 |
| Floor trims at 0.03 / 0.15 m/s, right wheel (PWM) | +46 / +47 | −11 / −9 |
| Gyro z at rest | −0.0122 rad/s | −0.0001 rad/s |
| Heading drift at rest from the gyro | 0.7°/s | 0.006°/s |

| 30 cm straight drive through `/cmd_vel` | Distance | Heading |
| :--- | ---: | ---: |
| Wheels (`/odom`), two drives | 30.9 and 31.3 cm | +1.8° and +2.3° |
| Gyro, second drive | | +1.8° |
| EKF as it was (`/odom_filtered`) | 30.9 and 31.3 cm | −14.9° and +47.3° |
| EKF with wheel speeds and the gyro's yaw rate only, second drive | 31.1 cm | +1.9° |
| SLAM's map pose | 6.5 and 28.8 cm | −35.9° and +41.2° |

**Result:** On the floor the right wheel needed about 46 PWM more than in the air at every speed, and the left wheel a steeper slope: the deadbands are now 58 and 88 and the slopes 1,893 and 1,740. With those, both wheels held the requests within 0.003 m/s. A first 0.15 m/s run lost the left encoder to a loose wire, reseated before these numbers. The gyro's values had only 2 decimals, which hid offsets of 0.01 to 0.06 rad/s. With 4 they were measured and are now subtracted in the firmware, but about 20 minutes into the ROS run z read +0.003 rad/s at rest again, likely from warming up. The EKF was the bigger problem. It fused the wheels' x and y as well as their speeds, and the uncalibrated accelerometer, and settled the conflicts by turning its heading, so straight drives read as turns and SLAM followed. At rest it saw a 16 mm/s sideways slide. An EKF fusing only the wheels' speeds, sideways included, and the gyro's yaw rate, run beside it, matched the wheels and the gyro. In Gazebo the same settings read 30.0 cm and 0.0° on a 30 cm drive, and through a turn followed the gyro's 71.7° rather than the wheels' 77.3°.

---

## 12. The EKF on the Robot, the Lidar's Frame and the Left Encoder

**Goal:** Check experiment 11's EKF settings on the robot, and find out why SLAM still disagreed.

**Setup:** `./robot.sh robot` with the new `ekf.yaml`, and the script from experiment 11: 60 s at rest, then 0.1 m/s for 3 s and 0.5 rad/s for 3 s through `/cmd_vel`. For the lidar, the median of 10 scans before and after placing an object around the robot. Then the corrected frame in Gazebo, where the simulated lidar turns with it.

| On the robot | Wheels (`/odom`) | Gyro | EKF (`/odom_filtered`) | SLAM's map pose |
| :--- | ---: | ---: | ---: | ---: |
| 30 cm straight | 31.0 cm, +2.7° | +2.3° | 30.9 cm, +2.4° | 22.0 cm, +12.8° |
| Left turn, 86° asked | +79.8° | +79.1° | +79.1° | +79.1° |
| Heading at rest, about 8 hours after power-on | 0.0°/min | +5.8°/min | +4.8°/min | +4.8°/min |

| Object placed | Where it showed in the scan |
| :--- | ---: |
| Straight ahead of the robot | +100° to +103° |
| Front-left, first try | +143° to +149° |
| Front-left, second try | +115° to +116° |

| In Gazebo, lidar turned −90° | Wheels | Gyro | EKF | SLAM's map pose |
| :--- | ---: | ---: | ---: | ---: |
| 30 cm straight | 30.2 cm, 0.0° | 0.0° | 30.2 cm, 0.0° | 30.2 cm, 0.0° |
| Left turn | +77.7° | +72.0° | +71.7° | +71.7° |

**Result:** The EKF now agrees with the wheels and the gyro on the floor, where the old settings read −14.9° and +47.3°, and follows the gyro through turns. At rest it follows the gyro's offset too, which had moved to 0.1°/s after about 8 hours powered, so learning that offset in the firmware matters. SLAM still read straight drives wrong, because the lidar's 0° points to the robot's right while `laser_joint` and a static transform in `main.launch.py` both said forward. A turn looks the same either way, so turns matched. Both, and the dashboard's lidar view, now turn the scan −90°. In Gazebo SLAM then matched the EKF, the dashboard's front distance read 2.94 m against 2.92 m in the scan straight ahead, and fitting the scan's change on the straight drive found the direction of travel at +87.1° for the true +90°. On the robot a −90° try was inconclusive: only the URDF had changed, and the launch file's static transform won on the next start. The two drives after it curved right, and the robot fell once, because the left encoder's B wire dropped out under power. It toggled 20 times while A toggled 122, the counts mostly cancelled, and the board drove that wheel harder until it flagged `no_counts`. The gyro read right turns (−19.7° and −13.3°) while `/odom` claimed left ones. A hand test after reseating passed, so the wire needs a proper fix before the lidar's exact angle is measured.

---

## What's Next

1. **Left encoder wire:** Fix the B wire properly, then check that both pins toggle about equally and that `/odom` agrees with the gyro on a floor drive.
2. **Calibration:** Measure the lidar's exact angle from the scan's change on a straight drive, and keep learning the gyro's offsets in the firmware while the wheels are stopped, since they drift as the robot warms up.
3. **Hardware mapping run:** A full mapping run and a Nav2 goal on the real robot.
4. **Camera in ROS:** A node that reads the ESP32-CAM stream, for camera-based docking, which is developed in a separate project.
