jakhon37/autoJetsonBot/assets/results/sim_slam_imu_frame_fix.png

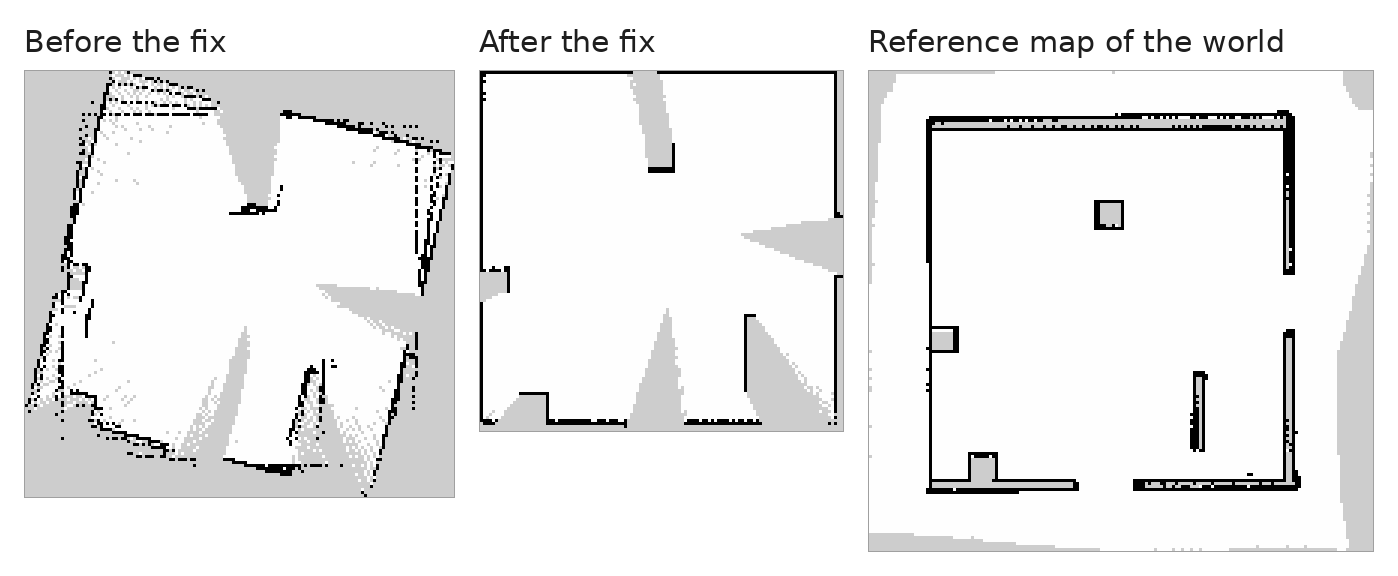
assets/results/sim_slam_imu_frame_fix.png
