jakhon37/autoJetsonBot/frames_debug.pdf

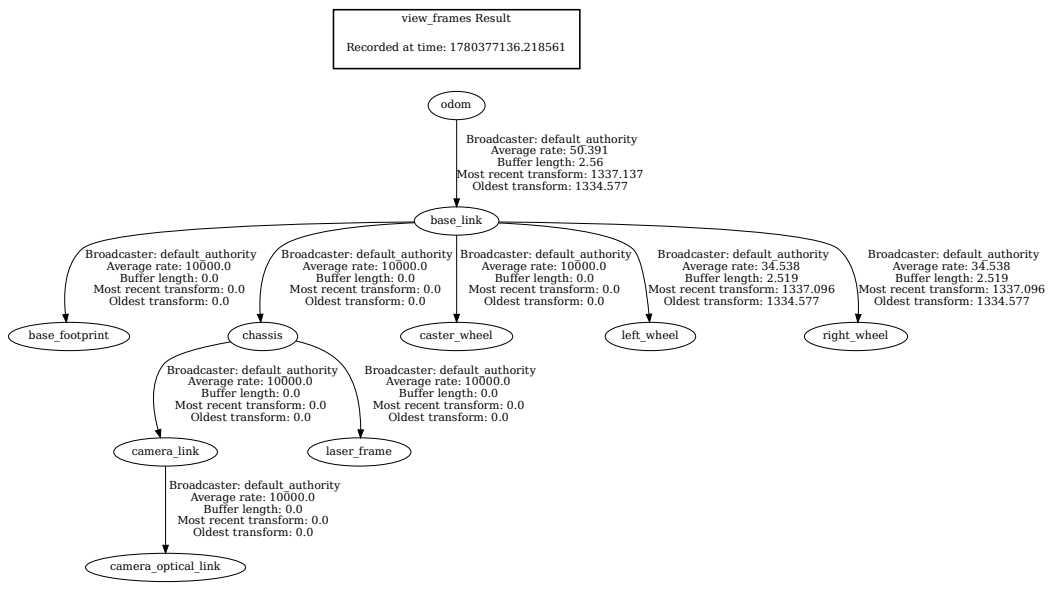
[picture p23: page 1]
view_frames Result; odom; base_link; Broadcaster: default_authority Average rate: 50.391 Buffer length: 2.56; Oldest transform: 1334.577; base_footprint; chassis; caster_wheel; left_wheel; right_wheel; camera_link; laser_frame; camera_optical_link

Recorded at time: 1780377136.218561

Most recent transform: 1337.137

Broadcaster: default_authority
Average rate: 10000.0
Buffer length: 0.0
Most recent transform: 0.0
Oldest transform: 0.0

Average rate: 34.538
Buffer length: 2.519
Most recent transform: 1337.096
Oldest transform: 1334.577
