jakhon37/autoJetsonBot/src/jetson_bot_bringup/config/unified_robot_config.yaml

# autoJetsonBot - Unified Configuration

# 🌍 Global Operational Parameters (The Robot's "Source of Truth")
global:
  ros__parameters:
    use_sim: false              # true: Gazebo simulation | false: Real hardware (Serial/IMU)
    mode: "mapping"            # options: "mapping", "navigation"
    viz: true                  # true: Open RViz2
    headless: false            # true: Run Gazebo in background (fast test) | false: Show Gazebo window
    use_sim_time: true          # true for sim (default for ./robot.sh sim); hw nodes override to false

    map_name: "lab_map_v2"        # Base name for saved/loaded maps
    # map_name: "demo_map"        # Base name for saved/loaded maps
    map_dir: "/autonomous_ROS/maps" # Persistent maps dir (hardware + sim friendly). Created if missing.
    gazebo_world: "lab_small_light.world"  # World file to load in simulation
    # gazebo_world: "demo.world"  # World file to load in simulation
    rviz_config: "default_nav2.rviz" # RViz config file to use

    # 📍 Initial Spawn Pose (Gazebo only)
    spawn_x: 0.0
    spawn_y: 0.0
    spawn_z: 0.06             # 6cm to ensure wheels clear ground (matches physical + docs/LESSONS_LEARNED.md)
    spawn_yaw: 0.0


# 🎮 ROS 2 Controller Manager parameters
controller_manager:
  ros__parameters:
    update_rate: 100
    use_sim_time: true  # sim default; hw path does not launch controller_manager
    
    diff_cont:
      type: diff_drive_controller/DiffDriveController
      
    joint_broad:
      type: joint_state_broadcaster/JointStateBroadcaster

# 🚗 Differential drive controller parameters
diff_cont:
  ros__parameters:
    use_sim_time: true  # overridden by launch for hw (false)
    left_wheel_names: ["left_wheel_joint"]
    right_wheel_names: ["right_wheel_joint"]
    wheel_separation: 0.212
    wheel_radius: 0.034
    publish_rate: 100.0
    base_frame_id: "base_footprint"
    odom_frame_id: "odom"
    enable_odom_tf: false  # the EKF publishes odom -> base_footprint, as on the robot
    # Same /odom covariance as the robot's bridge (jetson_bot_diffdrive/odometry.py)
    pose_covariance_diagonal: [0.001, 0.001, 1000000.0, 1000000.0, 1000000.0, 0.1]
    twist_covariance_diagonal: [0.001, 0.001, 1000000.0, 1000000.0, 1000000.0, 0.05]
    use_stamped_vel: false
    open_loop: false 

    # 🎢 Velocity & Acceleration Limits (Smooth Ramping)
    linear:
      x:
        has_velocity_limits: true
        max_velocity: 0.8
        min_velocity: -0.8
        has_acceleration_limits: true
        max_acceleration: 1.0
        min_acceleration: -1.0
    angular:
      z:
        has_velocity_limits: true
        max_velocity: 1.5
        min_velocity: -1.5
        has_acceleration_limits: true
        max_acceleration: 2.0
        min_acceleration: -2.0

# 🛠️ Joint state broadcaster parameters
joint_broad:
  ros__parameters:
    use_sim_time: true  # overridden by launch for hw (false)
    joints:
      - left_wheel_joint
      - right_wheel_joint
