jakhon37/autoJetsonBot/test/test_cam2.py

from picamera2 import Picamera2
import cv2

picam2 = Picamera2()
config = picam2.create_preview_configuration()
picam2.configure(config)
picam2.start()

frame = picam2.capture_array()
if frame is not None:
    cv2.imshow("Frame", frame)
    cv2.waitKey(0)
    cv2.destroyAllWindows()
else:
    print("Failed to capture frame")
