jakhon37/autoJetsonBot/(commit log)

2025-02-22 upload draft
    [inertial_macros.xacro, robot.urdf.xacro, robot_core.xacro]
2025-02-23 micro-ros esp32 motor control
    [inertial_macros.xacro, robot.urdf.xacro, robot_core.xacro]
2025-03-03 motor control without microros
2025-07-24 Update robotics framework - launch configs, simulation scripts, and controller settings
2026-06-03 major structureal update , joint/link bugs fixed
2026-06-05 ui upgrade slam nav camera support
2026-06-08 motor hardare deployment complete
2026-06-10 imu int | EKF sensor fusion | test
2026-06-12 jetson setup
2026-09-08 Remove macOS and slam-toolbox junk from the repo root.
    Tone the README down to the actual stack: Jetson, ESP32, SLAM, Nav2,
    Gazebo.
2026-11-05 Add the ROS 2 Humble Docker stack and hardware fixes from the Jetson.
    Saved from an uncommitted checkout on the Jetson (Xavier NX), last changed
    2026-08-18 to 08-21. Committed as found and not re-run for this commit.
    - Docker: Humble is now the default, built with Dockerfile.humble and
    ./robot.sh image. Foxy stays available with ROS_DISTRO=foxy. Gazebo
    Classic debs are not published for Humble on arm64, so ./robot.sh sim
    needs an amd64 host.
    - Launch and Nav2: pick the spawner, slam_toolbox argument and Nav2 params
    by distro, and add nav2_params_humble.yaml.
    - Serial: find the ESP32 and lidar by USB id instead of fixed ttyACM0 and
    ttyUSB0. diffdrive_node closes the port on serial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
2026-11-05 Remove the no-op use_sim_time line and the unused Dockerfile.
    slam_toolbox's launch file passes its use_sim_time argument after the params
    file, so the value in mapper_params.yaml never took effect. Tested both ways
    in the Humble image on the Jetson.
    Nothing references the plain Dockerfile: robot.sh and docker-compose use
    Dockerfile.humble and Dockerfile.foxy.
2026-11-05 Update the docs for the Xavier NX and Humble.
    Also mark the diffdrive_arduino warning as resolved, fix the wheel specs in
    GEMINI.md, and list the open hardware blockers on the status board.
2026-11-05 Fix the missing-lidar message printing None.
2026-11-05 Stop robot.sh status trusting an old ESP32 status file.
2026-11-05 Record the first Humble lidar test and the ESP32 and camera blockers.
2026-11-05 Add the ESP32 and camera history from the Jetson's kernel log.
2026-11-05 Point the missing-ESP32 error at the native USB socket.
2026-11-05 Correct the docs: the camera is an ESP32 on Wi-Fi.
2026-11-05 Stop odometry jumping when the bridge starts with nonzero counts.
2026-11-05 Record the ESP32-S3 read-only checks.
2026-11-05 Record the ESP32-CAM network test.
2026-11-05 Record the wheel test and camera firmware findings.
2026-11-05 Record the marked wheel test.
2026-11-05 Record the motor firmware recheck and the camera fix.
2026-11-05 Trace the motor firmware to MOTOR-ESP32S3 plus imu_viz.
2026-11-05 Record the camera firmware flash and the stream collapse.
2026-11-06 Record the charger test: network recovered, no frames at 640x480.
2026-11-06 Record the lens test: 640x480 works again, first boot unexplained.
2026-11-06 Record the 20-minute camera run at 640x480.
2026-11-07 Make ./robot.sh watch refresh status, and test the dispatcher.
    watch had two case arms. bash ran the first, a copy of verify's fusion
    checks, so the 10 s status loop never ran. verify keeps those checks.
    run_tests.py --unit runs the new test with stub docker, curl, clear and
    sleep commands, so it needs no container.
2026-11-07 Stop the bridge's odometry speeds spiking when encoder lines bunch up.
    dt was the time since the previous e line was handled, so the second of
    two lines read in one tick got a dt of microseconds. Now the lines read
    in one tick share the time since the last tick that had any, and none
    counts as shorter than one period of the new encoder_rate parameter
    (50 Hz, the flashed firmware's rate). The pose doesn't depend on dt.
    The odometry maths moves to odometry.py, which imports no ROS, so
    test_odometry.py runs with plain pytest.
2026-11-07 Give the bridge's /odom a non-zero covariance.
    It was all zeros, which robot_localization treats as near-perfect, so
    the EKF couldn't weigh the IMU against the encoders. x, y and vx get
    0.001. Yaw (0.1) and yaw rate (0.05) follow imu_nav2_roadmap_v2.md, so
    the gyro's 0.01 leads on rotation. The roadmap's 0.1 for vx isn't used:
    that is a 0.32 m/s standard deviation, more than the top speed.
    They are parameters with diff_drive_controller's names, so they can be
    tuned from the launch file.
2026-11-07 Leave odom -> base_footprint to the EKF in simulation.
    diff_cont published it too, so in simulation the transform switched
    between the raw and the fused odometry. With enable_odom_tf off, the EKF
    is the only publisher, as on the robot. The new bringup config test
    checks the two files agree.
2026-11-07 Give the simulated /odom the bridge's covariance.
    diff_drive_controller defaults to all-zero covariance diagonals, so the
    simulated EKF got the same near-perfect odometry the bridge used to
    send. Using the bridge's values keeps the twin's EKF inputs like the
    robot's.
2026-11-07 Drop odom_topic from the slam_toolbox config.
    slam_toolbox has no such parameter: it takes odometry from the
    odom -> base_footprint transform, which the EKF publishes. The line
    made it look as if slam_toolbox read /odom_filtered, which it never
    did. The SLAM config test now checks the frames instead.
2026-11-07 Check the web UI and rosbridge ports by connecting to them.
    The container runs with --network host, where docker port prints
    nothing, so the test always failed. It now connects to 8000 and 9090 on
    localhost, waiting up to 10 s, and skips while main.launch.py isn't
    running, since nothing listens then.
2026-11-07 Send dashboard goals and cancels the ROS 2 way.
    The goal and cancel buttons used ROSLIB.ActionClient, roslib 1.4.1's
    ROS 1 actionlib client, which rosbridge on ROS 2 doesn't serve. Goals
    now go to /goal_pose as a PoseStamped, which bt_navigator turns into a
    NavigateToPose goal as it does for RViz. The topic is advertised on
    connect, so the first goal isn't lost to discovery. Cancel calls
    /navigate_to_pose/_action/cancel_goal with an empty request, which
    cancels every goal, and logs the reply.
    The badge read status 3 as Recovering. It is CANCELING, which a working
    cancel now shows, so it reads Canceling.
2026-11-07 Mark the code review fixes on the status board and log the session.
    The Known Issues list now separates the seven fixes, each with what to
    check in simulation or on the robot, from what is still open. The
    getting-started guide says how to run the new unit tests.
2026-11-09 Stamp the simulated IMU's data with imu_link.
    The URDF mounts imu_link upside down, and the Gazebo plugin named no
    frame. Gazebo merges links on fixed joints into base_footprint, so the
    readings were stamped base_footprint and the EKF fused them without
    undoing the roll. Its heading turned the wrong way: in a 4 s
    counter-clockwise spin /odom measured +100 degrees and the EKF -86 to
    -95. diff_cont's transform hid this until enable_odom_tf went false,
    after which SLAM drew doubled walls and Nav2 weaved.
    With frame_name set, the EKF reads +95 degrees in the same spin. The
    new test fails on the old xacro.
2026-11-09 Stop throttling Nav2's goal status on the dashboard.
    rosbridge drops messages that arrive inside a subscription's
    throttle_rate window instead of delaying them. Nav2 sends CANCELED
    20 ms after CANCELING and publishes status only on a change, so with
    throttle_rate 500 the badge stayed on Canceling after every cancel. In
    Gazebo it now goes from Canceling to Idle within 30 ms.
    The goal's stamp comment was wrong too: rosbridge fills in its own ROS
    time when the header has no stamp.
2026-11-09 Record the Gazebo check of the code review fixes.
    The fixes ran in Gazebo under Humble on an amd64 PC. The status board
    now lists them as checked in simulation, apart from the bridge's
    changes, and adds the two bugs that run found and what it left open.
    The results page gets an eighth experiment with before and after SLAM
    maps, and AGENTS.md the lessons about sensor frames, rosbridge
    throttling and keeping a PC's simulation off the robot's network.
2026-11-09 Stamp the simulated camera's images with camera_optical_link.
    camera.xacro named its frame with ROS 1's frameName tag, which the
    ROS 2 camera plugin ignores, so Gazebo stamped /camera/image_raw with
    the merged root link, base_footprint. With frame_name the images are
    stamped camera_optical_link, the optical frame the URDF already
    defines. test_sensor_frames now covers the camera and fails on the old
    xacro.
2026-11-09 Record the camera frame fix from the Gazebo check.
2026-11-09 Move the lessons learned into docs/LESSONS_LEARNED.md.
    AGENTS.md becomes docs/LESSONS_LEARNED.md, next to the status board
    and the session log, and every link and mention now points there.
    GEMINI.md is removed: its commands, package list and robot specs are
    already in the README and the guides, and its debugging rules are in
    the lessons. Both names, and the other tool files like them, are in
    .gitignore so local copies stay out of the repo.
2026-11-09 Show the before and after SLAM maps in the README, and date the June visuals.
    The README's results now include the Gazebo SLAM figure from experiment
    8, which shows the simulated IMU frame fix. The Gazebo GIF and the
    costmap screenshot are marked as June 2026 on Foxy, since the stack is
    now Humble.
2026-11-09 Show only the latest Gazebo SLAM map in the README.
    The before and after figure gives way to the map slam_toolbox built in
    Gazebo under Humble on 2026-11-09, drawn like the real robot's map with
    a 1 m scale bar. The simulation bullet states the current result.
2026-11-09 Set the bridge's encoder_cpr to the measured 1,497.
    A hand test of 10 turns each way on both wheels, under the new motor
    firmware that counts all 4 encoder edges, gave 1,497, 1,496, 1,500 and
    1,496 counts per turn: 4 edges x 11 pulses x a 34:1 gearbox. The
    bridge had 3,436, which would have put /odom at 43% of the real
    distance. The launch file and the node's default both say 1,497 now.
    At that resolution one count in a 20 ms line is about 7 mm/s, so the
    odometry test's speed bounds now allow one count of rounding, and a
    straight move's heading is checked to within 1e-12 rather than exactly.
    The spike test still fails the bridge's old timing.
2026-11-09 Record the first drive with the new motor firmware.
    The status board, results page (experiment 9), session log, hardware
    docs, design note, bring-up guide and lessons learned now describe the
    2026-11-09/10 work: the old firmware backed up and replaced, the board
    stuck in download mode until a power cycle, the motor battery, both
    encoder B channels dead (a broken wire, and the left B on GPIO 14 not
    17), the left encoder's sign, 1,497 counts per turn, the tuned speeds
    and the 0.75 s stop. The README shows the latest motor results instead
    of the old encoder chart, which stays with experiment 5.
2026-11-09 Fuse the IMU's yaw rate in the EKF, not the IMU filter's yaw.
    Madgwick runs stateless and without a magnetometer, so its yaw comes
    from gravity alone and holds no heading. The EKF fused it as a yaw
    measurement anyway. In a flat 90 degree hand turn on the robot, the
    gyro measured the turn (-107 degrees in its upside-down frame, with
    the robot tilted no more than 1.5 degrees), but the EKF heading moved
    only 5.6 degrees. The EKF now takes heading changes from the IMU's
    yaw rate and the wheels' yaw rate. A config test checks it.
2026-11-09 Record the ROS drive and the EKF heading fix.
    Through /cmd_vel with the wheels lifted, /odom read 0.308 m for a
    0.30 m command and +89.9 degrees for +86. In a flat hand turn the
    gyro confirmed the IMU's sign, the EKF heading moved 5.6 degrees while
    fusing Madgwick's yaw and 105 after the fix, the rest being gyro bias.
    The status board, results page (experiment 10), session log, lessons
    learned, architecture page, IMU roadmap and README say so, and that
    the gyro bias, now about 1 degree per second of drift at rest, needs
    calibrating before a mapping run.
2026-11-09 Fuse only the wheels' speeds and the gyro's yaw rate in the EKF.
2026-11-09 Record the floor tuning, the gyro offsets and the EKF fix.
2026-11-10 Turn the lidar's frame to match how it's mounted.
    On the robot the lidar's 0 degree points to its right: an object straight
    ahead showed at +101 degrees in the scan, and objects to the front-left at
    +115 and +145. With the frame saying forward, SLAM read a 31 cm straight
    drive as 22 cm and a 12.8 degree turn, while turns, which look the same
    either way, matched.
    The frame is set in two places, laser_joint in lidar.xacro and the static
    laser_frame_broadcaster in main.launch.py, and TF keeps whichever copy
    arrives last, so both now say -90 degrees. The dashboard's lidar view drew
    scans as if 0 degree were forward, so it turns them by the same yaw.
    New config tests check that the launch file'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
2026-11-10 Record the EKF's check on the robot, the lidar's frame and the left encoder.
    The new ekf.yaml read +2.4 degrees on a 30 cm drive, with the wheels at +2.7
    and the gyro at +2.3, and the gyro's 79.1 degrees through a turn. The same
    session found the lidar turned 90 degrees from its frame, and the left
    encoder's B wire dropping out under power, which curved two drives right.
    The status board, results (experiment 12), session log, lessons, README and
    TF diagram are updated.
2026-11-10 Record the gyro offsets the motor firmware now learns at rest.
    Since 2026-11-10 17:00 the robot's motor board runs MOTOR-ESP32S3's
    gyro-offset-learning branch (e23d577), which re-learns the gyro's offsets
    whenever the robot stands still. At rest the gyro then read within
    0.00002 rad/s of zero, and the EKF's heading moved -0.11 degrees a minute,
    where it had crept +4.8 earlier that day. The learned offsets matched a
    reading of the old firmware, taken just before the flash, within
    0.0002 rad/s. The status board (the gyro blocker is done), results
    (experiment 13), session log, lessons, README and hardware pages are updated.
