jakhon37/autoJetsonBot/assets/upfront_rb.png

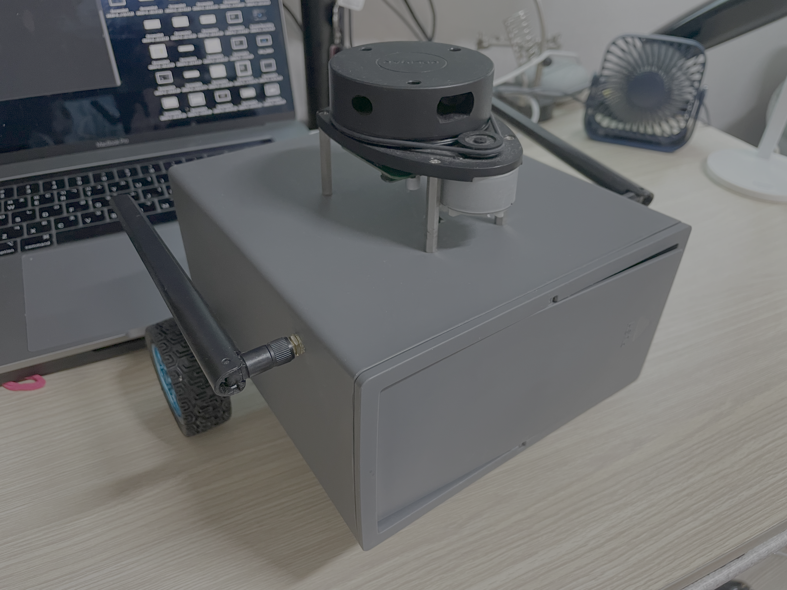
assets/upfront_rb.png
